muhammetalidev/samsung-tv-power-bypass/TV Güç Kartı v1.0.pdf

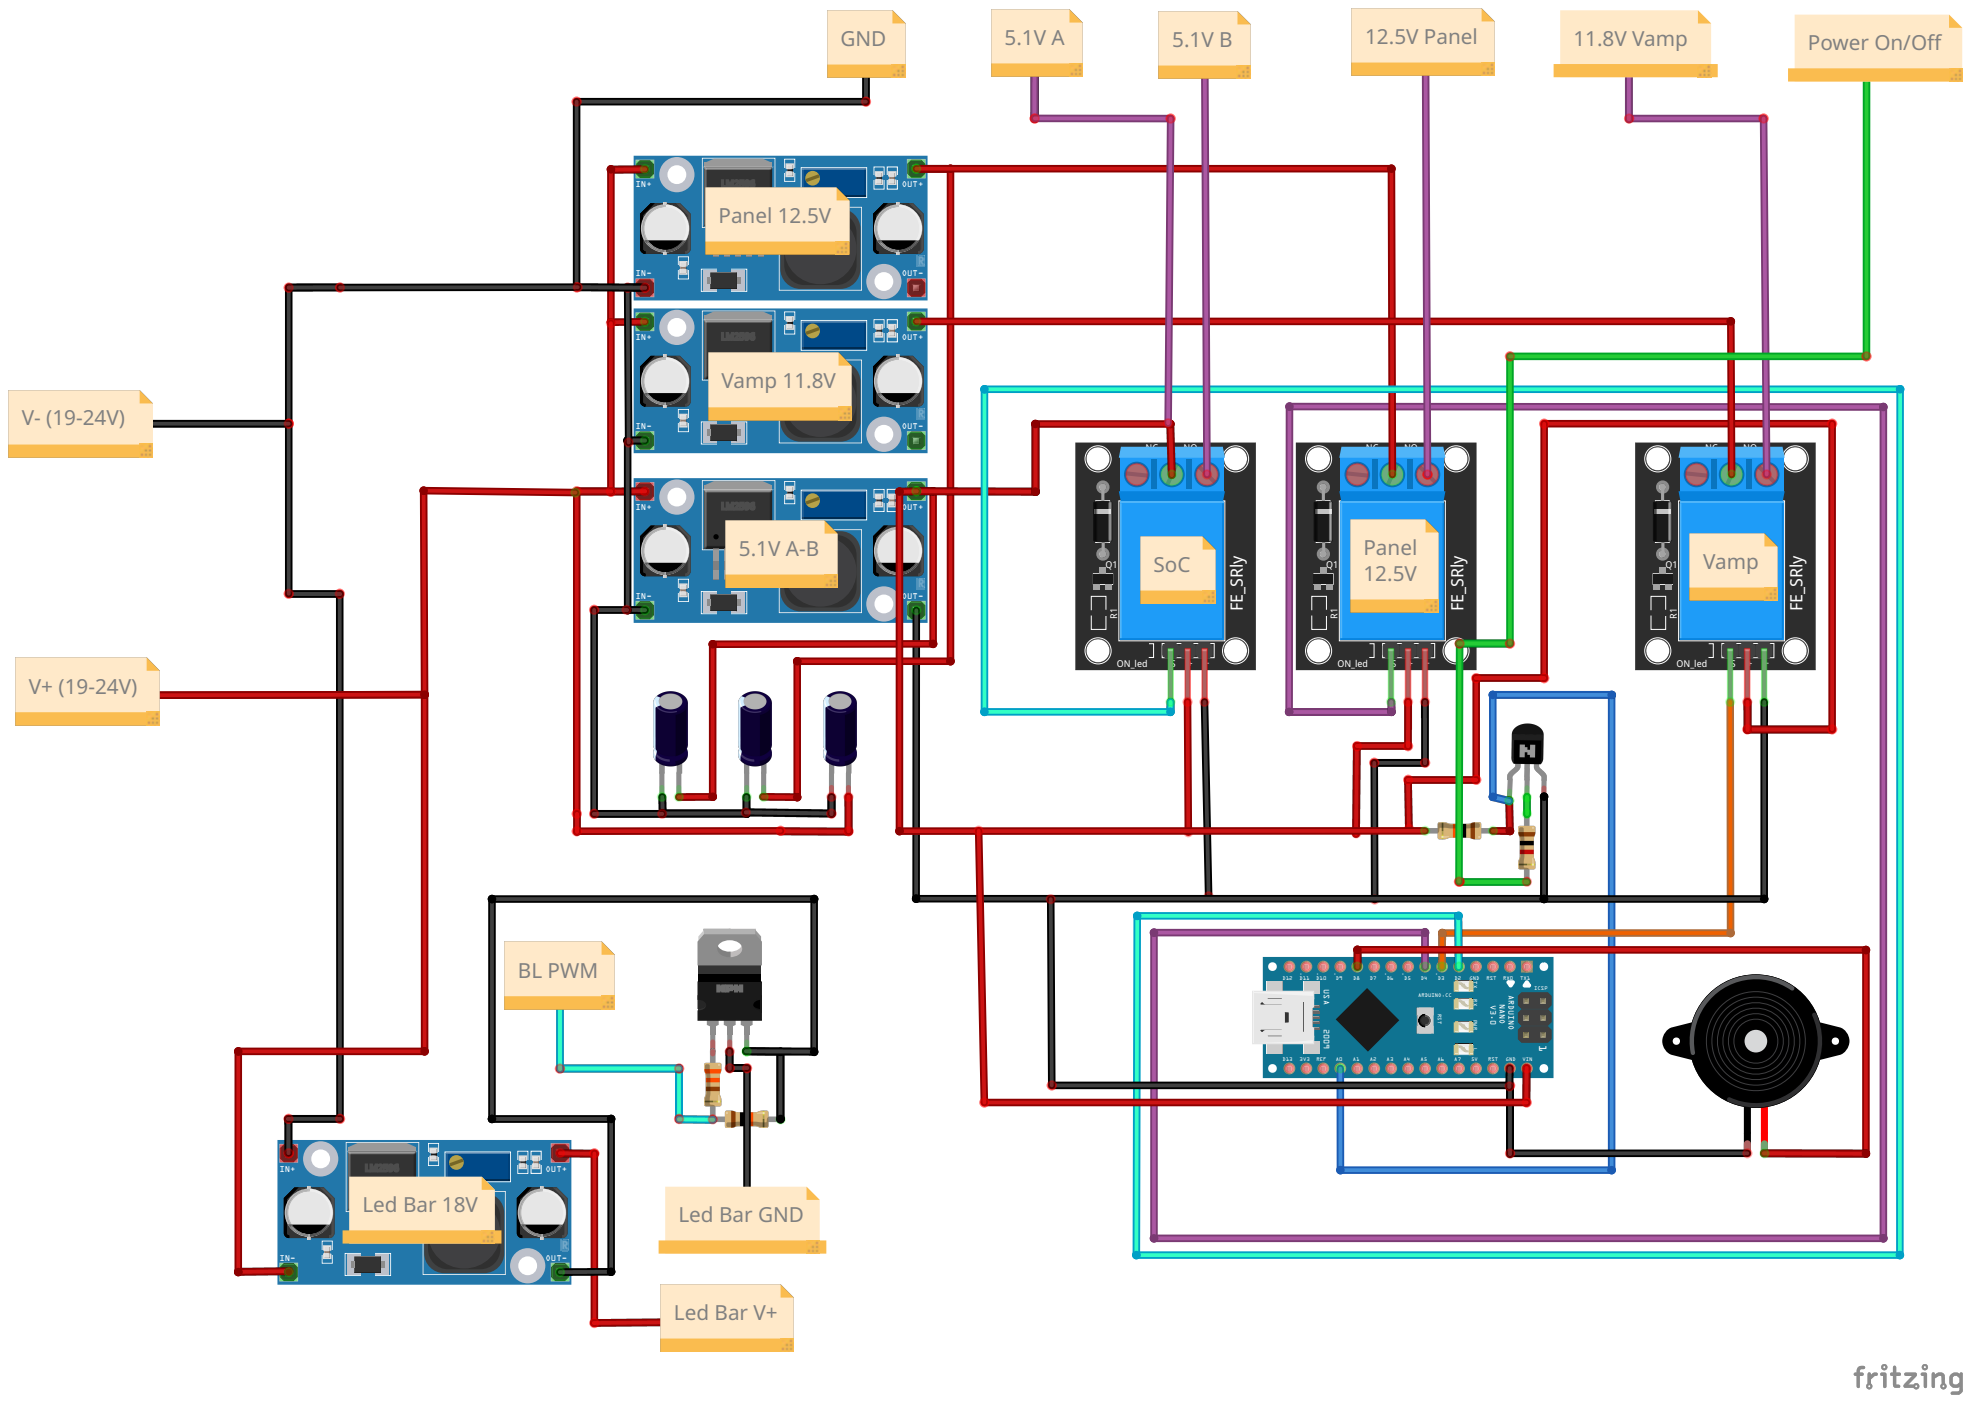
[picture p2: page 1]
