muhammetalidev/samsung-tv-power-bypass/(commit log)

2026-07-04 Fix image table formatting in README
    Adjusted the layout of the circuit schematic and system setup images in the README.
2026-07-04 Rearrange schematic and system images in README
2026-07-04 Fix order of images in schematic overview
